daid/Az8muth/kicad/Backplane.v0/Backplane.kicad_pcb

## KiCad design kicad/Backplane.v0/Backplane.kicad_pcb (2025-07-15)

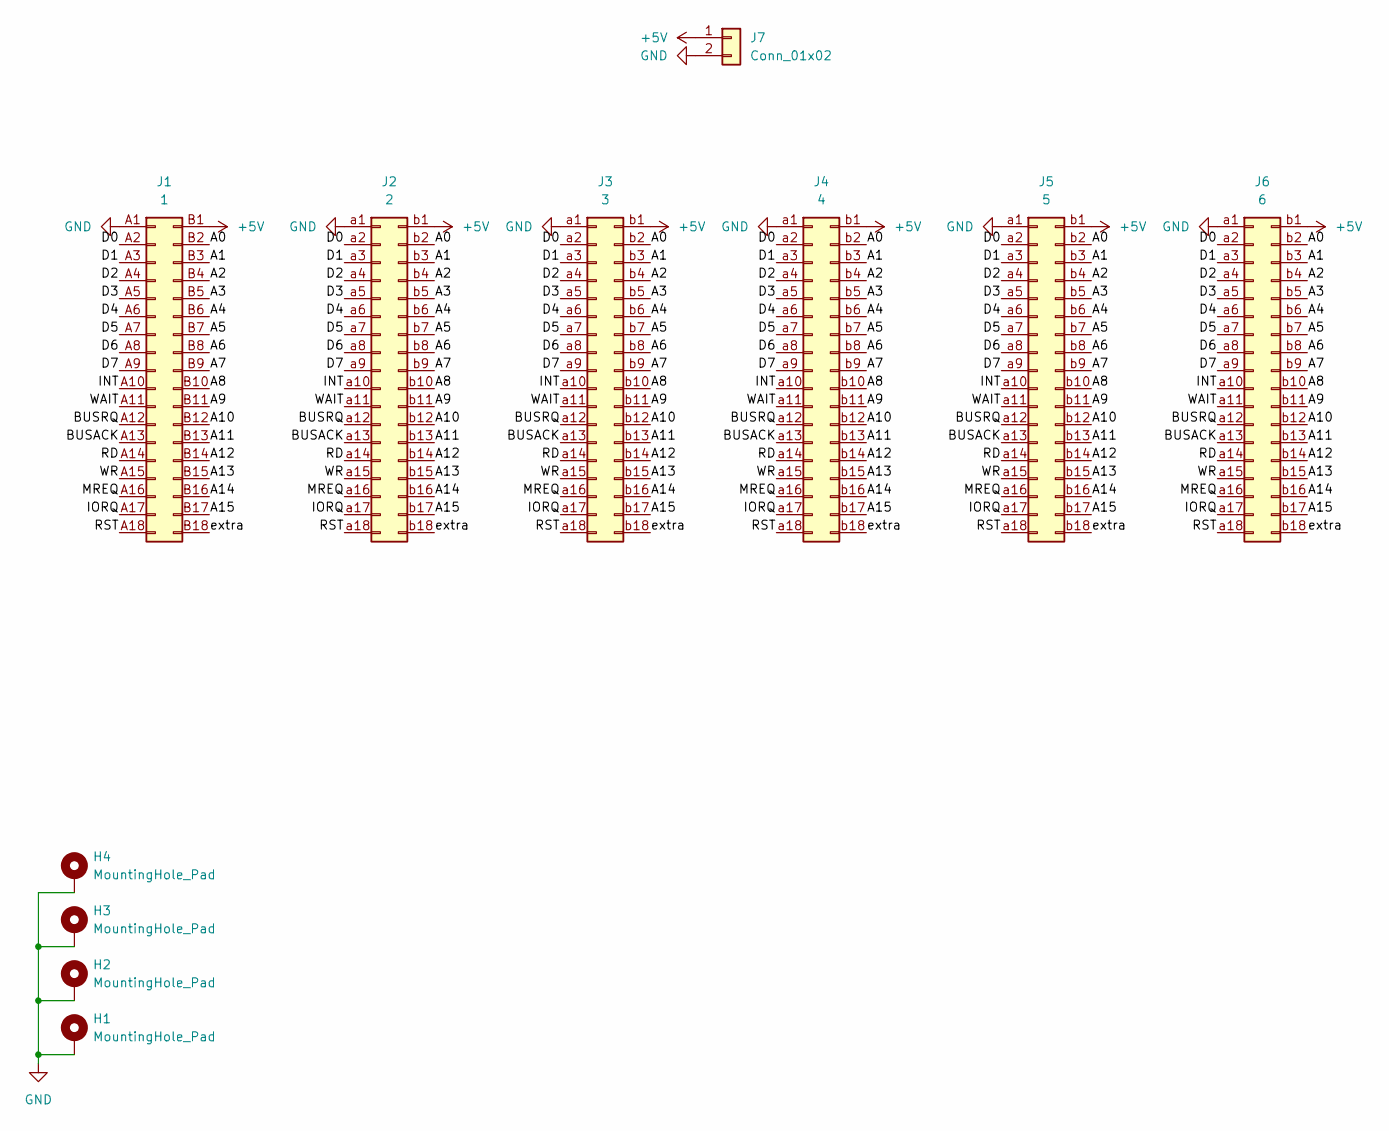
[picture p2: schematic Backplane.kicad_sch]

Parts:
H1, H2, H3, H4: MountingHole_Pad; MountingHole_3.2mm_M3_Pad
J1: 1; BUS_PCIexpress_x1
J2: 2; PCI-E36P
J3: 3; PCI-E36P
J4: 4; PCI-E36P
J5: 5; PCI-E36P
J6: 6; PCI-E36P
J7: Conn_01x02; PinHeader_2x01_P2.54mm_Vertical

Connections:
+5V: J1.B1 (Pin_b1), J2.b1, J3.b1, J4.b1, J5.b1, J6.b1, J7.1
/A0: J1.B2 (Pin_b2), J2.b2, J3.b2, J4.b2, J5.b2, J6.b2
/A1: J1.B3 (Pin_b3), J2.b3, J3.b3, J4.b3, J5.b3, J6.b3
/A2: J1.B4 (Pin_b4), J2.b4, J3.b4, J4.b4, J5.b4, J6.b4
/A3: J1.B5 (Pin_b5), J2.b5, J3.b5, J4.b5, J5.b5, J6.b5
/A4: J1.B6 (Pin_b6), J2.b6, J3.b6, J4.b6, J5.b6, J6.b6
/A5: J1.B7 (Pin_b7), J2.b7, J3.b7, J4.b7, J5.b7, J6.b7
/A6: J1.B8 (Pin_b8), J2.b8, J3.b8, J4.b8, J5.b8, J6.b8
/A7: J1.B9 (Pin_b9), J2.b9, J3.b9, J4.b9, J5.b9, J6.b9
/A8: J1.B10 (Pin_b10), J2.b10, J3.b10, J4.b10, J5.b10, J6.b10
/A9: J1.B11 (Pin_b11), J2.b11, J3.b11, J4.b11, J5.b11, J6.b11
/A10: J1.B12 (Pin_b12), J2.b12, J3.b12, J4.b12, J5.b12, J6.b12
/A11: J1.B13 (Pin_b13), J2.b13, J3.b13, J4.b13, J5.b13, J6.b13
/A12: J1.B14 (Pin_b14), J2.b14, J3.b14, J4.b14, J5.b14, J6.b14
/A13: J1.B15 (Pin_b15), J2.b15, J3.b15, J4.b15, J5.b15, J6.b15
/A14: J1.B16 (Pin_b16), J2.b16, J3.b16, J4.b16, J5.b16, J6.b16
/A15: J1.B17 (Pin_b17), J2.b17, J3.b17, J4.b17, J5.b17, J6.b17
/BUSACK: J1.A13 (Pin_a13), J2.a13, J3.a13, J4.a13, J5.a13, J6.a13
/BUSRQ: J1.A12 (Pin_a12), J2.a12, J3.a12, J4.a12, J5.a12, J6.a12
/D0: J1.A2 (Pin_a2), J2.a2, J3.a2, J4.a2, J5.a2, J6.a2
/D1: J1.A3 (Pin_a3), J2.a3, J3.a3, J4.a3, J5.a3, J6.a3
/D2: J1.A4 (Pin_a4), J2.a4, J3.a4, J4.a4, J5.a4, J6.a4
/D3: J1.A5 (Pin_a5), J2.a5, J3.a5, J4.a5, J5.a5, J6.a5
/D4: J1.A6 (Pin_a6), J2.a6, J3.a6, J4.a6, J5.a6, J6.a6
/D5: J1.A7 (Pin_a7), J2.a7, J3.a7, J4.a7, J5.a7, J6.a7
/D6: J1.A8 (Pin_a8), J2.a8, J3.a8, J4.a8, J5.a8, J6.a8
/D7: J1.A9 (Pin_a9), J2.a9, J3.a9, J4.a9, J5.a9, J6.a9
/INT: J1.A10 (Pin_a10), J2.a10, J3.a10, J4.a10, J5.a10, J6.a10
/IORQ: J1.A17 (Pin_a17), J2.a17, J3.a17, J4.a17, J5.a17, J6.a17
/MREQ: J1.A16 (Pin_a16), J2.a16, J3.a16, J4.a16, J5.a16, J6.a16
/RD: J1.A14 (Pin_a14), J2.a14, J3.a14, J4.a14, J5.a14, J6.a14
/RST: J1.A18 (Pin_a18), J2.a18, J3.a18, J4.a18, J5.a18, J6.a18
/WAIT: J1.A11 (Pin_a11), J2.a11, J3.a11, J4.a11, J5.a11, J6.a11
/WR: J1.A15 (Pin_a15), J2.a15, J3.a15, J4.a15, J5.a15, J6.a15
/extra: J1.B18 (Pin_b18), J2.b18, J3.b18, J4.b18, J5.b18, J6.b18
GND: H1.1, H2.1, H3.1, H4.1, J1.A1 (Pin_a1), J2.a1, J3.a1, J4.a1, J5.a1, J6.a1, J7.2

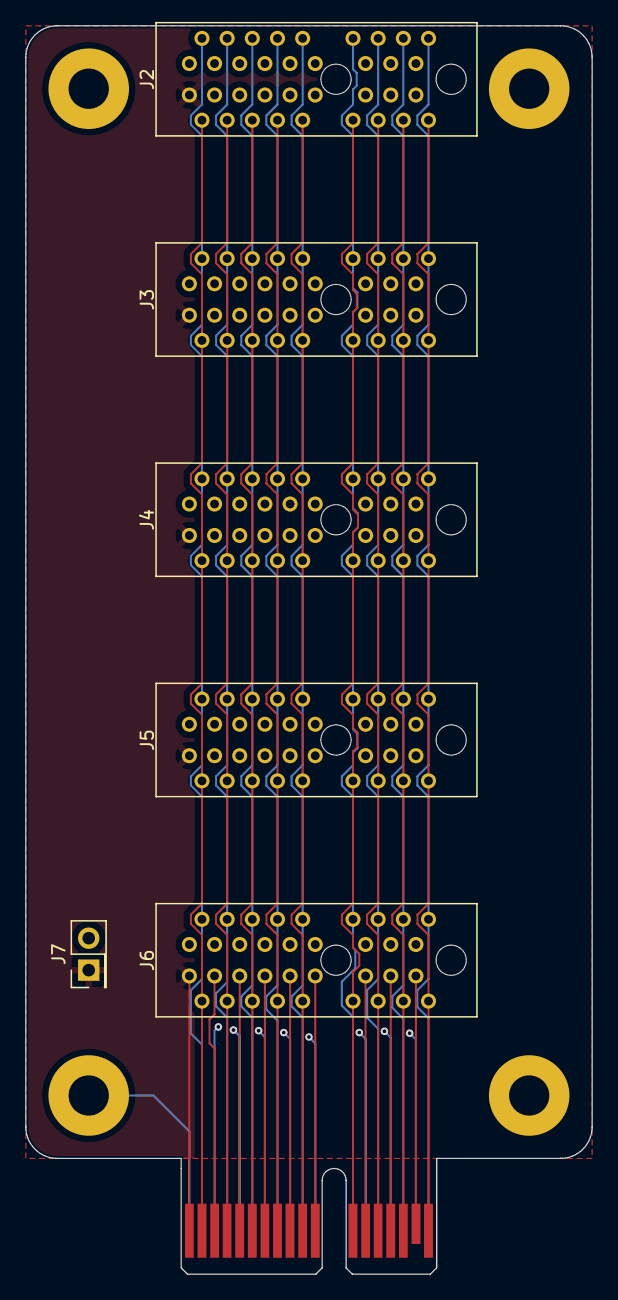
[picture p3: board Backplane.kicad_pcb from above]

Board: 4 copper layers, 45.0 x 99.2 mm, 11 parts (0 on the bottom side), 36 nets.
